vtl/volvo-cem-cracker/doc/LCD_PIN_display.jpg

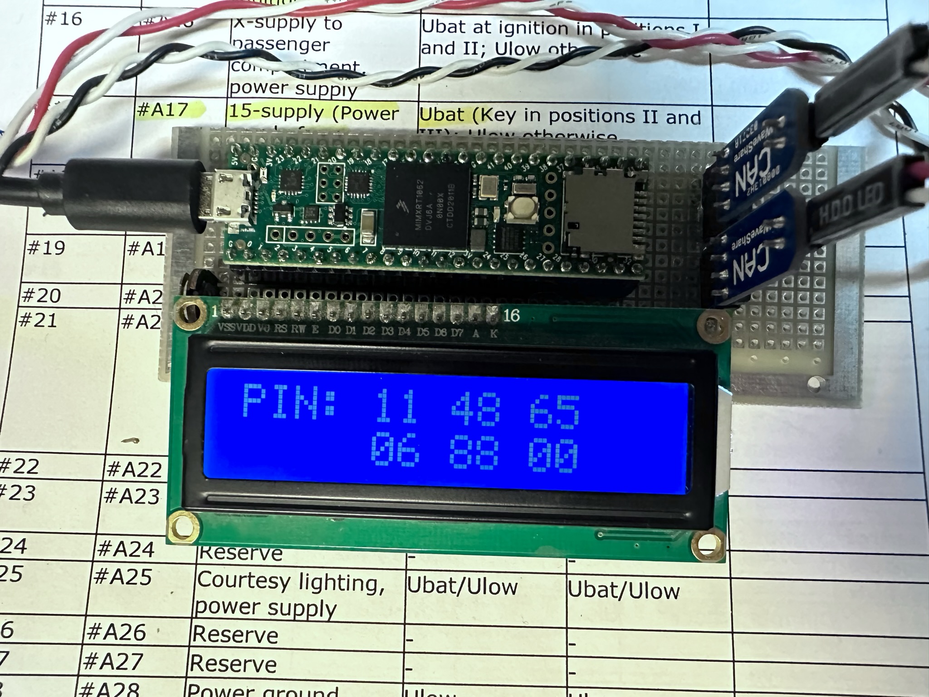
doc/LCD_PIN_display.jpg
