vtl/volvo-cem-cracker/doc/LCD_progress_display.jpg

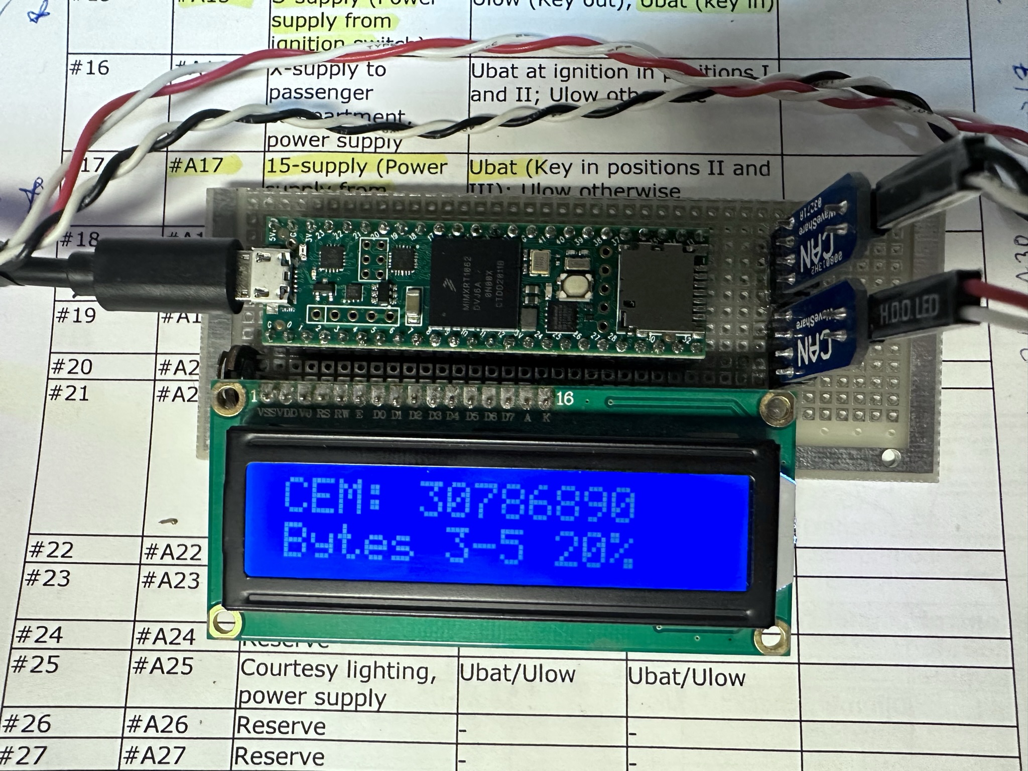
doc/LCD_progress_display.jpg
