vtl/volvo-cem-cracker/(threads)

Thread 4 (2021-02-02):

Problem with cracking some PIN codes in P2

smyku22, 2021-02-02:
I noticed that with some PIN codes, for example: 179955542746, the algorithm is not able to crack it.

vtl, 2021-02-02:
Show the log?

smyku22, 2021-02-02:
[Crack_PIN_log.txt](https://github.com/vtl/volvo-cem-cracker/files/5914106/Crack_PIN_log.txt)

vtl, 2021-02-02:
Try to increase SAMPLES to 50 or 60. Or reduce CALC_BYTES to 2.

PrancingMoose, 2021-02-02:
Sorry to jump on here but how do you run the program, am using Windows 7 pro 64Bit, need to crack my cem pin, thanks

vtl, 2021-02-02:
You need to solder the Arduino (Teensy 4.0 + CAN-bus), compile the source code and program the hardware.

smyku22, 2021-02-02:
[Crack_PIN_100_samples_log.txt](https://github.com/vtl/volvo-cem-cracker/files/5914571/Crack_PIN_100_samples_log.txt)
I increased the number of samples to 100 and it gets worse. He has a problem with the second PIN byte.

vtl, 2021-02-02:
Your MCP2515 seems to add a lot of noise. The one I have gives a latency aligned to 2 microseconds (see video), while yours disperse the latency in every bucket around CEM's latency.

The code also supports Teensy's built-in CAN-controllers, you only need to add a CAN-transceiver, like SN65HVD230. Just attach its RX/TX pins to the Teensy's pins related to CAN.

I think I'll drop MCP2515 support, since it is so unreliable. Also a built-in simplifies the schematics, since it does not need a level shifter.

smyku22, 2021-02-02:
But as I don't use MCP2515. I use Teensy 4.0 and SN65HVD230. Could you please check this PIN on your CEM? If you want, I can send you the Flash program, from my CEM. I discovered that if the second byte of PIN is 99 then there is a problem with cracking. When the 2nd PIN byte changes to any other, the CEM is able to crack.

maxdenisov, 2021-02-25:
Hi, does anyone have success through ODB2?
I have some issues with it:

pin[2] candidate: 81 with latency 709670
Candidate PIN 0x74 0x54 0x81 -- -- -- : brute forcing bytes 3 to 5 (3 bytes), will take up to 695 seconds
Progress: 0%..done

found PIN: 0x55 0x54 0x00 0x74 0x00 0x81
PIN is cracked in 1372.35 seconds
Validating PIN
PIN verification failed!
done

frankhommers, 2023-05-21:
I got it working when brute forcing the last 4 pairs. The first 2 pairs were always the same result, after that it was basically random.

Closed 2021-03-18.

Thread 15 (2022-12-02):

2002 volvo v70xc , Need to read the pincode from CEM.

vikingzvolvo, 2022-12-02:
Can anyone assist in this Teensy and Arduino thing ? how to go about it after ordering these two things?
All keys lost scenario. Autel does not cover the chip in CEM. And i want to be able to read from the obd port. Thanks !

vtl, 2022-12-02:
Brick-style CEMs (99-04) are not crackable yet. You need to take the CEM out and solder a bunch of wires to read it with BDM programmer. See MVS forum, it has an Arduino-based solution.

Or blow the flash chip off with hot air and read it normally in a programmer.

vikingzvolvo, 2022-12-12:
Hi, sorry for late reply but thanks for your email to me. I actually found
online and also saw on YouTube a video where someone actually accessed this
Motorola chip version on these cars right from OBD. And retrieved pincode !
 I am not able to get a reply from this YouTuber and I will find that video
again and forward you the link.
  It has been really done really achieved and I just want to get to know
exactly how !

If you like stay in touch maybe we may end up being friends or just solving
a situation like this. Thanks.

Imran khan

On Fri, Dec 2, 2022, 11:13 Vitaly Mayatskikh ***@***.***>
wrote:

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

imransterling, 2023-01-18:
> Brick-style CEMs (99-04) are not crackable yet. You need to take the CEM out and solder a bunch of wires to read it with BDM programmer. See MVS forum, it has an Arduino-based solution.
>
> Or blow the flash chip off with hot air and read it normally in a programmer.

Apparently you are not really aware of facts concerning this matter. Read it for yourself !
A research project grown out of curiosity. Cracks 6 bytes of pin code via High Speed CAN-bus in under 20 minutes.

Supported platforms:

P1:
2004 - 2011 S40
2004 - 2011 V50
2008 - 2013 C30
2006 - 2013 C70
P2:
2005 - 2006 S80
2005 - 2007 V70
2005 - 2007 XC70
2005 - 2009 S60
2003 - 2014 XC90
**### **Earlier P2 1999-2004 can be supported as well, CEM donation is welcome.****

Find us at Matthew's Volvo Site for support: https://www.matthewsvolvosite.com/forums/viewtopic.php?f=10&t=85611

RickHaleParker, 2023-01-21:
> I didn't understand what you've tried to say here.

Artifact in the Readme "Earlier P2 1999-2004 can be supported as well".

sanjurjo-miguel, 2024-03-04:
Hey everybody,
has there been any progress on this? Is "Brick-style CEMs (99-04) are not crackable yet" still current?
Is there any chance of these CEM being crackable soon?
Thanks,

vtl, 2024-03-05:
Nobody has spent any time on brick-shaped CEMs after that.

sanjurjo-miguel, 2024-03-06:
My V70 from 2004 has a brick-shaped CEM (30657629) that I need to be cracked.
For that purpose I would very much like to contribute to this project in any way: I'm fit in coding and know my way around electronics, embedded devices, etc... but I'm inexperienced in this particular field (CEM cracking) though... could you give me some hints on how to get started?

vtl, 2024-03-06:
> My V70 from 2004 has a brick-shaped CEM (30657629) that I need to be cracked. For that purpose I would very much like to contribute to this project in any way: I'm fit in coding and know my way around electronics, embedded devices, etc... but I'm inexperienced in this particular field (CEM cracking) though... could you give me some hints on how to get started?

Read CEM flash directly and find PIN in the file: https://www.matthewsvolvosite.com/forums/viewtopic.php?p=609357#p609357

We brick-shaped CEMs can't be cracked: https://www.matthewsvolvosite.com/forums/viewtopic.php?p=582635#p582635, and the next post.

Thread 16 (2023-01-16):

EasyEDA file

frankhommers, 2023-01-16:
Hi there,

Can you supply the easyEDA export (json) file next to the schematic?
Thanks!
Frank

vtl, 2023-01-16:
Check it out.

frankhommers, 2023-01-20:
Pretty please...? ;)

vtl, 2023-01-20:
Connections looks good. I would add P/N for buck converter (and state it is 12->5 volts converter), as well as mark U3 and U5 as shields, not bare chips.

frankhommers, 2023-01-20:
Awesome! I actually don't know the part numbers as I bought most from AliExpress.

[SCH_volvo-cem-cracker-breadboard-version_2023-01-20.zip](https://github.com/vtl/volvo-cem-cracker/files/10469294/SCH_volvo-cem-cracker-breadboard-version_2023-01-20.zip)

Thread 17 (2023-01-26):

Volvo XC90 CEM pin crack pcb

Constantinos11, 2023-01-26:
Good evening to everyone
I have been for a cheap but effective way to unlock my cem pin.
I found this method but I'm having a hard time with a pcb file which I found for the job
The pcb has all the wiring, it just needs the teensy 4.0 and the SN65HVD230 transceivers.
However, on the schematic, I can see that some resistors that need installing, but I'm not sure where to install them on the pcb.
I know that some resistors are only used for bench cem cracking so I should make it know that I intend to do the cem cracking through the obd2 port.
Another query I have is whether to get the teensy 4.0 with the pin already on or just the bare board

The pcb link:
https://www.pcbway.com/project/shareproject/Volvo_CEM_Pin_Decoder_c4d037d5.html

I look forward to your reply.

Best wishes,
Constantinos

RickHaleParker, 2023-01-27:
That is the PCB for the Bosh CF160 version. See: Bosh CF160 version.pdf in the docs folder.

Constantinos11, 2023-01-27:
I have seen it, but since I can’t find any Bosch cf160 in my country, I was wondering if I could use SN65HVD230 transceivers instead of the Bosch cf160.
Do the SN65HVD230 transceivers need receivers?

vtl, 2023-01-27:
No, transceiver does both RX and TX.

RickHaleParker, 2023-01-27:
A Ebay seller in Texas has a bunch of Bosch CF160. He will ship world wide.

Constantinos11, 2023-01-27:
Can you provide a link as I have not been able to source them

Constantinos11, 2023-01-27:
> No, transceiver does both RX and TX.

Does this mean that I can use this pcb with SN65HVD230 transceivers instead of Bosch CF160 and not add resistors?

vtl, 2023-01-27:
> > No, transceiver does both RX and TX.
>
> Does this mean that I can use this pcb with SN65HVD230 transceivers instead of Bosch CF160 and not add resistors?

Yes. Original schematic uses them.

https://github.com/vtl/volvo-cem-cracker/blob/master/doc/schematic.png

Constantinos11, 2023-01-27:
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

Yes, it does, however the schematic includes two resistors (r1 and r2) which are not included on the pcb.

vtl, 2023-01-27:
> Yes, it does, however the schematic includes two resistors (r1 and r2) which are not included on the pcb.

I didn't do any PCB. SN65HVD230 datasheet asks for 10k resistors. 120 Ohm resistors depend on how the CEM is attached (on bench, in car). Buy any CAN shield with SN65 or Bosch, they will have resistors and jumper to disconnect 120 Ohm one.

Constantinos11, 2023-01-27:
>

> > Yes, it does, however the schematic includes two resistors (r1 and r2) which are not included on the pcb.
>
> I didn't do any PCB. SN65HVD230 datasheet asks for 10k resistors. 120 Ohm resistors depend on how the CEM is attached (on bench, in car). Buy any CAN shield with SN65 or Bosch, they will have resistors and jumper to disconnect 120 Ohm one.

I meant the pcb that I had linked

https://www.pcbway.com/project/shareproject/Volvo_CEM_Pin_Decoder_c4d037d5.html

However, I can see that this would only work with cf160 because the SN65HVD230 needs 10k resistors and I don’t know where in the pcb to add them.

Would you recommend using the pcb or just making it by using a breadboard instead?

RickHaleParker, 2023-01-28:
> Can you provide a link as I have not been able to source them

https://www.ebay.com/itm/192811194444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

RickHaleParker, 2023-01-28:
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

That PCB is for this build version:
https://github.com/vtl/volvo-cem-cracker/blob/master/doc/Volvo%20CEM%20PIN%20Cracker.%20Bosh%20CF160%20version.pdf

Constantinos11, 2023-01-28:
Would TCAN1042HVDR work?

vtl, 2023-01-28:
> Would TCAN1042HVDR work?

Perhaps

Constantinos11, 2023-01-29:
Do you know how I can verify this before buying all the parts?

RickHaleParker, 2023-01-29:
> Would TCAN1042HVDR work?
That V in the suffix makes it questionable. What would the I/O voltage be with Vio floating?
A version like TCAN1044A-Q1 ( no V in suffix ) looks like it would work.

Minimum order on the PCBs is 5. You would have some extra PCBs.

vtl, 2023-01-29:
> Do you know how I can verify this before buying all the parts?

Compare datasheets. I did, and see nothing major against using it. VCC to +5v, VIO to 3.3v.

RickHaleParker, 2023-02-05:
> > Do you know how I can verify this before buying all the parts?
>
> Compare datasheets. I did, and see nothing major against using it. VCC to +5v, VIO to 3.3v.

Constantinos11, 2023-04-20:
https://github.com/vtl/volvo-cem-cracker/blob/master/doc/schematic.png
In this pcb, where does the CAN-GND (OBD-II pin 5) connect to apart from the obd plug?

vtl, 2023-04-20:
> https://github.com/vtl/volvo-cem-cracker/blob/master/doc/schematic.png In this pcb, where does the CAN-GND (OBD-II pin 5) connect to apart from the obd plug?

All ground points are connected together.

Thread 21 (2023-12-18):

Hopeing you could add support for teensy LC

KennethMcNutt, 2023-12-18:
To use the MCP2551 transceiver with a Teensy LC microcontroller, you can follow these steps:

Step 1: Wiring
Connect the MCP2551 to your Teensy LC as follows:
- VCC to 5V on Teensy LC.
- GND to GND on Teensy LC.
- TXD to SPI MOSI (pin 11 on Teensy LC).
- RXD to SPI MISO (pin 12 on Teensy LC).
- CS to a digital pin (e.g., pin 10) on Teensy LC.
- INT (if used) connected accordingly.

Step 2: Install Libraries
In your Arduino IDE, install the "MCP_CAN_lib" by visiting "Sketch -> Include Library -> Manage Libraries", then search for and install the library.

Step 3: Initialize MCP2515
You'll require code similar to this in your setup function:
```cpp
#include https://github.com/Longan-Labs/Arduino_CAN_BUS_MCP2515
#include Adafruit MCP2515](https://reference.arduino.cc/reference/en/libraries/adafruit-mcp2515/
#include https://github.com/autowp/arduino-mcp2515

MCP2515 mcp2515(10); // Assuming CS pin is connected to digital pin 10

void setup() {
    Serial.begin(115200);
    SPI.begin();
    mcp2515.reset();
Step 4: Setting Bitrate
To set the CAN bit rate to 500 kbps, you can use the `setBitrate` function. For example:
```cpp
    mcp2515.setBitrate(CAN_500KBPS);
```

Step 5: Sending CAN Message
Here's an example of how you can send a CAN message using MCP2515 from your loop or main function:
```cpp
void loop() {
    // Prepare message
    uint8_t data[8] = {0x01, 0x02, 0x03, 0x04, 0x05, 0x06, 0x07, 0x08};
    CAN_message_t msg;

    msg.id = /* Set the ID of your message */;
    msg.len = sizeof(data);
    memcpy(msg.buf, data, sizeof(data));

    // Send the prepared message using MCP2515
    mcp2515.sendMessage(&msg);

    delay(100); // Add a delay if necessary

}
```

In summary:
- Connect the MCP2551 transceiver to your Teensy LC.
- Install the "MCP_CAN_lib" library in Arduino IDE.
- Initialize and configure the MCP2515
I'm not sure if this will work..
and you may know an easier way than using two IC's ?

vtl, 2023-12-18:
Teensy's built-in CAN is better and cheaper.

Thread 23 (2024-02-09):

possibility of ECM pin decoding

Juxols, 2024-02-09:
Hi,
So basicly there is a growing demand for p3 volvos with bosch or denso ecu / ecm unit for their PIN decryption / cracking.

User4728147, 2024-02-09:
and i mean if it could be possible to do with basic J2534 interface like Dice?

FabsHazard, 2025-03-03:
i would like to know the same thing as well

Thread 24 (2024-03-13):

Evry time first 3 pair digits of pin is different.

Kuliok, 2024-03-13:
Evry time first 3 pair digits of pin is different

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
CEM 8690719
S40 II 2004 USA

vtl, 2024-03-14:
719/720 are special. Try this: https://github.com/cmolson/volvo-cem-cracker/tree/one_pass

Kuliok, 2024-03-14:
Thank you its working! Got pin.
Shoud I repit search again to confirm pin?

Thread 25 (2024-03-27):

Unknown CEM error

Drekith-1, 2024-03-27:
Hi. New here first off I’m not a programmer or anything just a fairly tech savvy handsy guy with too much free time. Anyway I’ve followed the schematics for the lcd version using a teensy 4.0
However when I try to decode the cem the lcd displays unknown cem exiting……..

I’ve triple checked my connections are quality and true to the schematic as well as reloading the software onto the teensy a few times yet I get the same error. Is it likely I’ve just done something wrong or is it just not possible with my cem.

V50 2007/2008 D5 facelift

vtl, 2024-03-29:
https://github.com/cmolson/volvo-cem-cracker/tree/one_pass

Drekith-1, 2024-03-31:
Worked a treat. Another successful read thanks guys 👌 drls are finally now off via vdash.
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

Closed 2024-03-31.

Thread 26 (2024-04-22):

Problem with CAN LS

Balboa84, 2024-04-22:
Hi.
I built your device, programmed it but I have a problem. After detecting a part number, the CEM calculates something for a minute and displays a CAN LS error and operation stops. I have tried on two Volvo vehicles P1 and P2. Could the problem be that the CAN wires are not twisted?

Thread 29 (2024-05-17):

2004 XC90  CAN_LS error

dreiduke, 2024-05-17:
It says always Initializing, then CAN-LS Error   unknown CEM Exiting...
no matter if car is closed locked, or open, or Key is in position I or II

vtl, 2024-05-17:
Remove CEM_PN_AUTODETECT and set those to what your car has:

```
#else
  can_ls_init (CAN_125KBPS);
  can_hs_init (CAN_500KBPS);
  progModeOn ();
  pn = ecu_read_part_number_prog (CAN_HS, CEM_HS_ECU_ID);
#endif
```

RickHaleParker, 2024-05-18:
2004 P2 is a CEM-B. It never will get a response unless your cracker has a K-line OR you tap into the network some place other then the OBD connector.

Thread 31 (2024-11-27):

What could be the problem?

smfilip, 2024-11-27:
Hello, today I have received all components and assembled them, but can't extract the PIN, receiving errorr (screenshot).
CEM is 0030765643
What could be the problem that could cause this?
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

Thread 33 (2025-07-04):

Cant crack CEM PIN ON VOLVO 31296001 MODULE

Kuliok, 2025-07-04:
Can't crack pin on VOLVO 31296001
(Last 2 pairs)
Volvo v50 2010 1.6D
