vtl/volvo-cem-cracker/doc/Schematic_Volvo-CEM-L-(50)-cracker_2024-02-01.pdf

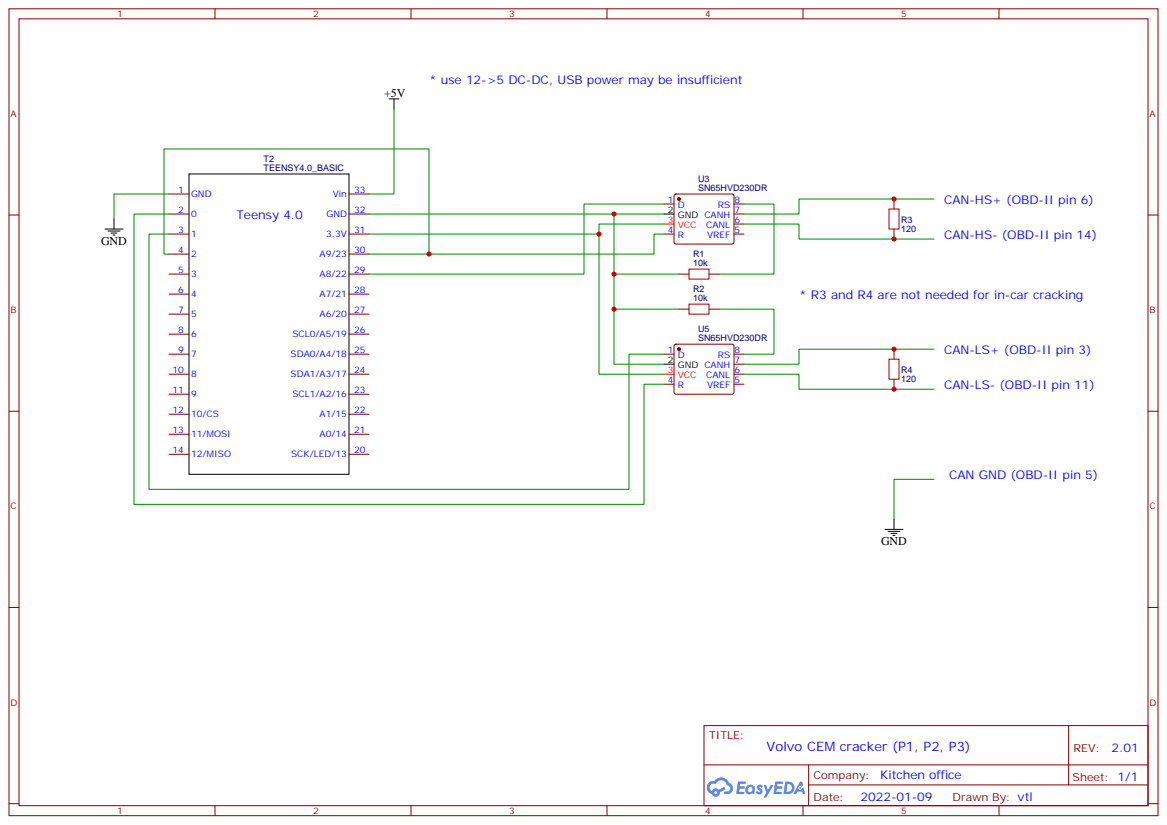
[picture p6: page 1]

* use 12->5 DC-DC, USB power may be insufficient

CAN-HS+ (OBD-II pin 6)

* R3 and R4 are not needed for in-car cracking

CAN-LS+ (OBD-II pin 3)

CAN GND (OBD-II pin 5)

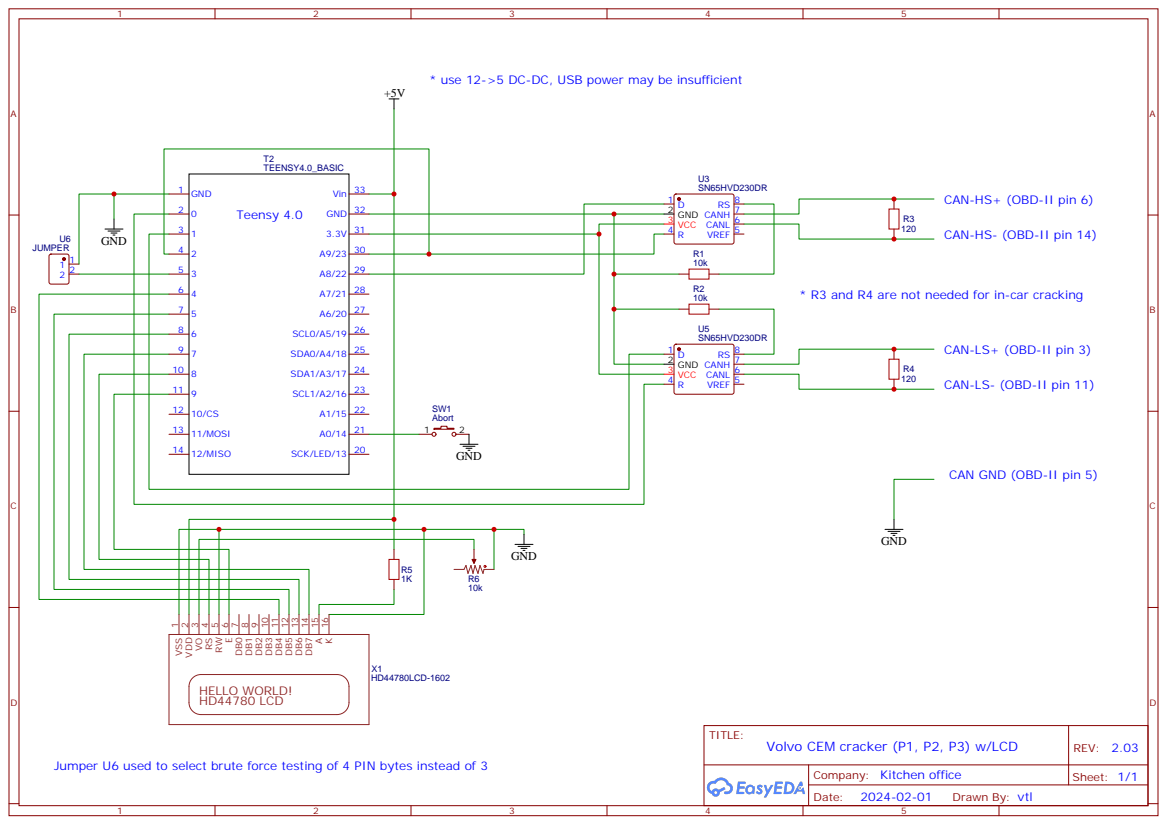
[picture p7: page 2]

* use 12->5 DC-DC, USB power may be insufficient

CAN-HS+ (OBD-II pin 6)

* R3 and R4 are not needed for in-car cracking

CAN-LS+ (OBD-II pin 3)

CAN GND (OBD-II pin 5)

Jumper U6 used to select brute force testing of 4 PIN bytes instead of 3
