vtl/volvo-cem-cracker/doc/Volvo CEM PIN Cracker. Bosh CF160 version.pdf

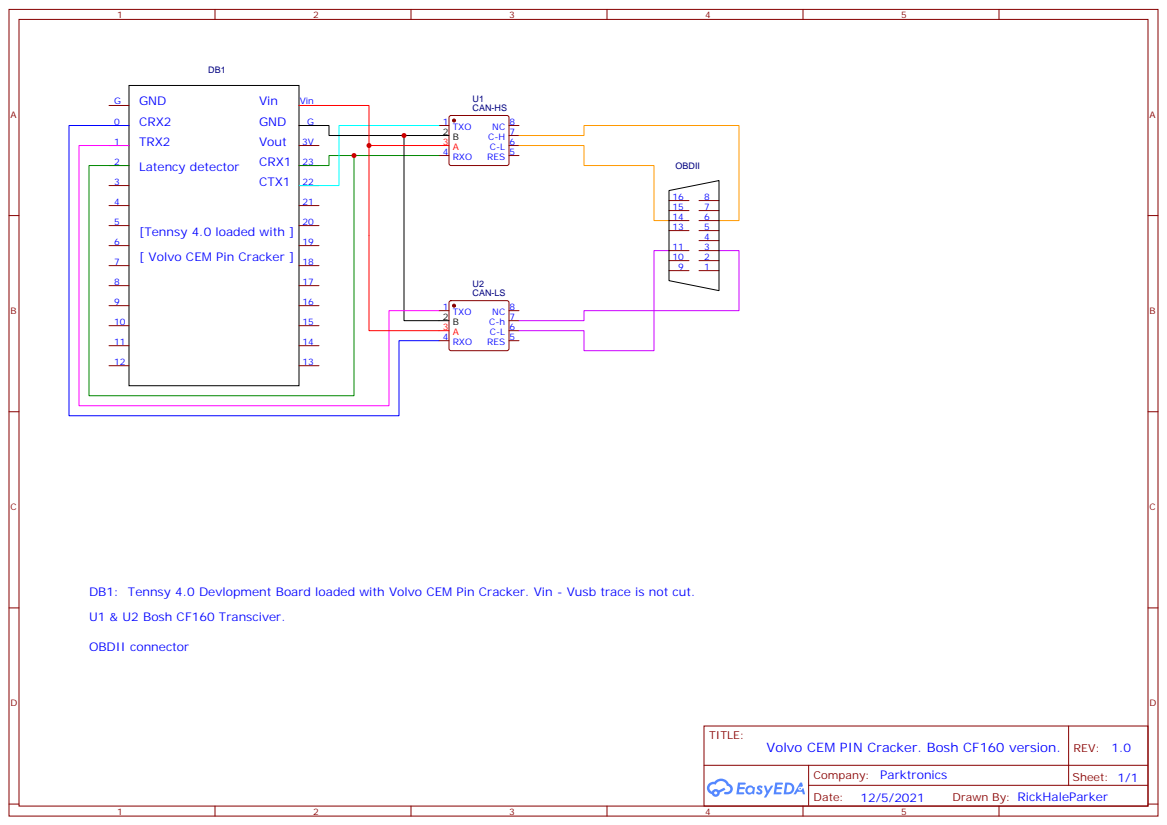
[picture p8: page 1]

DB1: Tennsy 4.0 Devlopment Board loaded with Volvo CEM Pin Cracker. Vin - Vusb trace is not cut.
U1 & U2 Bosh CF160 Transciver.
