vtl/volvo-cem-cracker/(list of files, drawings)

Other design files:
doc/SCH_Volvo CEM-L (50) cracker_2023-01-16.json
doc/SCH_Volvo-CEM-L-(50)-cracker_2024-02-01.json
