vtl/volvo-cem-cracker/(commit log)

2020-10-14 Add schematic
2020-10-16 Add latency diagnostics
    It seems the first approach does not work on all CEMs. So we need
    more data to analyze and adjust the algo.
    [volvo-cem-cracker.ino]
2020-10-16 Need the known pin in diagnostics
2020-11-05 Get rid of ESP32
2020-11-09 CAN-L is pin 10
2020-11-10 Optionally send both CAN-buses into programming mode
2020-11-19 Add support for the Volvo P1 Platform.
    I tried to keep the defaults the same as the P2 branch.
    Two main difference:
    * No shuffle required on P1 platform when sending pin
    * Used average response time to calculate best guess
2020-11-20 Add support for built-in Teensy CAN controller.
2020-11-20 Make it clear in schematic that it needs an external +5v power and commond GND with CEM
2020-11-21 Add interrupt support for Teensy CAN controller.
2020-11-22 Fixed printing the cracked PIN, byte shuffling needs to be considered.
    Print periodict progress messages during the brute force phase.
    Added a validation phase to ensure the cracked PIN is functional.
    [volvo-cem-cracker.ino]
2020-11-24 Adjust Teensy 4.x CPU frequency to achieve more predictable results.
2021-01-03 Major clean-up of the code base and internal documentation. Output is improved to make it easier to see which PIN digit is being worked on. All configuration options have been moved to be near the to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
2021-01-10 Update schematics
2021-03-16 Switch default target to Teensy built-in CAN controllers
2021-03-27 Forgot to route pin 2 to CAN-HS RX
2021-04-28 Get rid of BUCKETS_PER_US
2021-04-28 Support only Teensy 4.0 with built-in CAN controllers
2021-05-03 Don't print BCD as HEX
2021-05-03 Send both CAN-buses into prog mode at the same time.
2021-05-03 Ooops... Wrong pin position was used.
    [volvo-cem-cracker.ino]
2021-05-03 Print worst lat and std as well.
2021-10-08 Prevent TSC overrun and early termination of latency detection.
    [volvo-cem-cracker.ino]
2021-10-08 Rewrite candidate election algorithm
    Start with low samples value, elect half of the best candidates, increase samples,
    repeat until resolved.
    [volvo-cem-cracker.ino]
2021-11-22 Update volvo-cem-cracker.ino
    Add support for CEM-L Part number 30728356.
    [volvo-cem-cracker.ino]
2021-12-07 Schematic for Bosch CF160
    Add schematic for Bosch CF160 transceiver.
2021-12-17 P1 parameters Update. (#11)
    Confirmed many of the Shuffle orders from PIN and .bin files provided by ZRimaZ .
2022-01-09 Add explicit Teensy/OBD GND connection on schematic
2022-01-13 Revert "P1 parameters Update. (#11)" (#13)
    This reverts commit 301e5da7d349d37ae309df77b07c7b86c1da641d.
    [volvo-cem-cracker.ino]
2023-01-16 Add EasyEDA schematic export
    [SCH_Volvo CEM-L (50) cracker_2023-01-16.json]
2023-03-30 Update volvo-cem-cracker.ino (#18)
    The shuffle order for the CEM 31296881 should be 2, 4, 5, 0, 3, 1 (marked 3 in code). Confirmed on Volvo C70 II 2010 P1 with chassis number 115484.
    [volvo-cem-cracker.ino]
2024-01-02 Added support for LCD displays using the Hitachi HD44780 controller.
    The standard Arduino LiquidCrystal library is used to manage the
    LCD display.
    An LCD display is not required to be connected to the Teensy, but
    if it is present, it will be used to display status information.
    With an LCD display it is no longer necessary to monitor the
    serial port for progress and the cracked pin, it will be shown
    on the display.
    Some general code clean up as well to eliminate warnings, no
    algorithmic changes.
    [SCH_Volvo CEM-L (50) cracker_2023-07-21.json]
2024-02-02 Added support for an abort button.
    Data line 14 (pin 21) is used as an active low signal to indicate that the
    cracking should terminate immediately and exit PROG mode on all connected
    ECUs. When used in the vehicle, this will stop all PIN cracking and restore
    all normal vehicle operations.
    Data line 3 (pin 5) is used to select between brute force testing of the
    last 3 or 4 PIN bytes. Grounding the data line will select brute force
    testing of the last 4 PIN bytes.
    [SCH_Volvo CEM-L (50) cracker_2023-07-21.json, SCH_Volvo-CEM-L-(50)-cracker_2024-02-01.json]
2026-10-02 Disable ARM's speculative execution for higher stability of the latency poller.
    Committed-by: Vitaly Mayatskikh <vitaly@gravicappa.info>
2026-10-31 Show the candidate PIN in byte order
    The PIN now displays in actual byte order, not shuffle order.
2026-10-31 Wait for the operator to power the CEM
    Added a wait for the operator to power the CEM instead of racing it.
